tatedavenport/SwimmingSwarm/README.md

# Software Documentation
## Running the Code
- 2/25/2020 Release 0.0.1
- - Run Controller.py on the topside computer `python ./controller.py -mode joystick` (you can also pass 'keyboard' as the mode to use WASD + QE + CTRL + SHIFT for control)
- - Run Robot.py on the raspberry pi `python ./robot.py -host HOST_IP -port 8080` (passing the topside computer's ip in place of HOST_IP)

More usage information can be found [here](Documentation/Software/Usage.md).

## Setup
Follow the links from top to bottom for complete installation.

### [Topside Computer](Documentation/Software/TopsideComputer.md)
### [Raspberry Pi](Documentation/Software/RaspberryPi.md)
### [Pixhawk](Documentation/Software/Pixhawk.md)
-----

# Electrical Documentation
## [Electrical Design](Documentation/Electrical/ElectricalProduction.md)
## [ESC Setup](Documentation/Electrical/ESCs.md)
## [Electrical Hardware Information](Documentation/Electrical/ElectricalHardware.md)
-----

# [Mechanical Documentation](Documentation/Mechanical/Production.md)
-----

# Troubleshooting
See the Troubleshooting section [here](Documentation/Troubleshooting.md)
