tatedavenport/SwimmingSwarm/Documentation/Electrical/ElectricalHardware.md

# MicroSD Card 
Variety of brands. Just make sure you have at least a 16 GB card to insure you have enough memory for the .img.

# Raspberry Pi Zero W
[Raspberry Pi Link](https://www.adafruit.com/product/3400)

# Batteries: 
Size: 18650  
Nominal Capacity: 2500mAh  
Nominal Voltage: 3.7V   
Maximum Voltage: 4.2V
*[more information](https://secondlifestorage.com/t-LG-LGDBHE21865-Cell-Specifications--1938)*

## Charging Batteries
The batteries can now be charged via the BMS board (listed below). Plug a 5-24VDC power source into the barrel jack (> 2amp recommended). Batteries are fully charged when all 3 LEDs are lit. We've been using a 24V power supply.

# Battery Managment Board
[Dayton Audio LBB-3v2](https://www.parts-express.com/Dayton-Audio-LBB-3v2-3-x-18650-Lithium-Battery-Charger-Board-Module-12V-with-Charge-Protect-325-201) 3x 18650 Lithium Battery Board with Charge Protection

# Pixhawk - PX4
[PX4](https://docs.px4.io/en/flight_controller/pixhawk.html)

# Power Distribution board 
12V and 5V BEC w/ LC filtering supports up to 3A current.  
Size: 36 x 50 x 8mm
Net weight: 11g

[PDB Link](https://www.amazon.com/FPVDrone-Matek-PDB-XT60-Distribution-Quadcopter/dp/B06ZYFY89Z)

# Brushless DC Motors 
[Horizontal Thrusters](https://www.amazon.com/Crazepony-ECO2306-2400KV-Brushless-Racing/dp/B07T717JCC) - 2300KV Brushless Motors

[Vertical Thrusters](https://www.amazon.com/FPVDrone-7500KV-Brushless-Racing-Quadcopter/dp/B077GKLSP7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) (outdated)

# Electronic Speed Controllers
[ESC link](https://www.amazon.com/Makerfire-BLHeli-Brushless-Controller-QAV210/dp/B07867ZMFJ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) (outdated)
