tatedavenport/SwimmingSwarm/Documentation/Images/Masterpiece.png

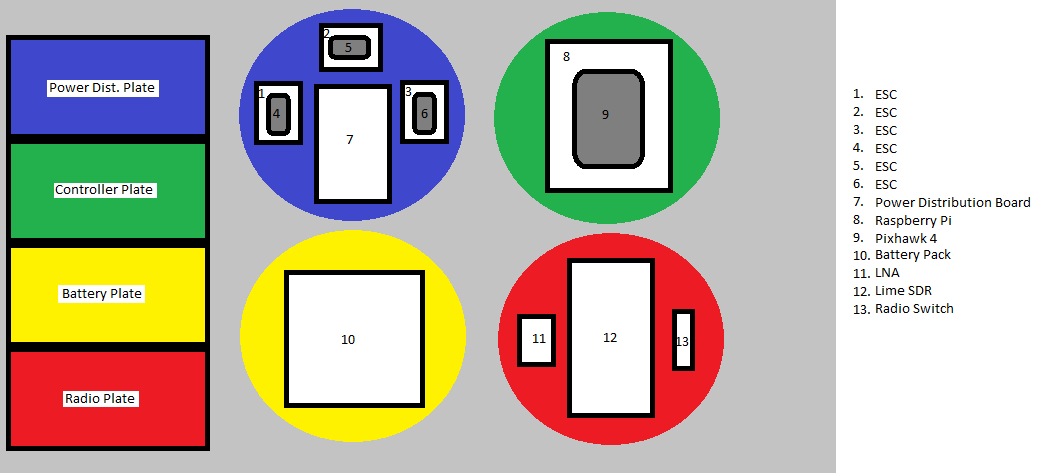
Documentation/Images/Masterpiece.png
