tatedavenport/SwimmingSwarm/Documentation/Swimming Swarm Parts List.xlsx

Sheet: Mick's Bots Components
Name | Manufacturer | Part # | Price | Quantity Needed | Purchase Link | Dimensions | Mass | Notes
Heat-Set Inserts, M4 x 0.7 mm, 4.7 mm | McMaster Carr | 94180A353 | $8.62 per 50 | 1 | https://www.mcmaster.com/#94180a353/=1d9pru1 |  |  | 5.7 - 5.99
Button Head Hex Screw, M2 x 0.40 mm, 8mm Long | McMaster Carr | 92095A454 | $6.38 per 25 | 1 | https://www.mcmaster.com/#92095a454/=1dgbvdc
Extended-Tip Set Screws, M4 x 0.7 mm, 8mm | McMaster Carr | 92775A118 | $7.29 per 25 | 1 | https://www.mcmaster.com/#92775a118/=1de9t0b
18-8 Stainless Steel Dowel Pin, M4 x 16 mm | McMaster Carr | 91585A454 | $7.91 per 26 | 1 | https://www.mcmaster.com/#91585a454/=1dgbhkh
Button Head Hex Drive Screw, M4 x 10 | McMaster Carr | 92095A190 | $9.05 per 100 | 1 | https://www.mcmaster.com/#92095a190/=1dec0au
O-Ring (162) | McMaster Carr | 9452K181 | $9.24 | 1 | https://www.mcmaster.com/#9452K181
Button Head Hex Drive Screw, M2 x.4mm | McMaster Carr | 92095A451 | $3.75 | 2 | https://www.mcmaster.com/#92095A451
18-8 Stainless Steel Hex Nut | McMaster Carr | 91828A111 | $4.50 | 1 | https://www.mcmaster.com/#91828A111
18-8 Stainless Steel Threaded Rod | McMaster Carr | 90024A219 | $4.86 | 1 | https://www.mcmaster.com/#90024A219
Sheet Lead (1/8'' thickness) | Amazon |  | $31 per 1sq ft | 1 | https://www.amazon.com/gp/product/B00IS5EEZ6/ref=s9_dcacsd_dcoop_bw_c_x_5_w
Brass Rods | Amazon |  | $13.11 | 1 | https://www.amazon.com/Unpolished-Finish-Temper-Diameter-Length/dp/B00GWYMPOC?s=industrial
18650 Battery Holder | Amazon |  | $5.66 |  | https://www.amazon.com/SMAKN%C2%AE-Plastic-Battery-Holder-Batteries/dp/B00NX8PW9A
MT30 Connector | HobbyKing |  | $3.27 per 4 | 2 | https://hobbyking.com/pt_pt/mt30-3-pole-motor-esc-connector-set-16awg-male-female-4-sets.html?___store=pt_pt
Red Wire | HobbyKing |  | $1.14 | 1 | https://hobbyking.com/en_us/turnigy-high-quality-20awg-silicone-wire-2m-red.html?___store=en_us
Black Wire | HobbyKing |  | $1.39 | 1 | https://hobbyking.com/en_us/turnigy-high-quality-20awg-silicone-wire-2m-black.html?___store=en_us
7500 KV Brushless Motor | GearBest |  | $7.59 | 4 | https://www.gearbest.com/motor/pp_634541.html?wid=1433363&currency=USD&vip=4264393

Sheet: Electronics
Name | Manufacturer | Part # | Price Per Component | Quantity Needed | Quantity Have | Dimensions | Mass | Notes | Purchase Link
Computers
Pixhawk |  |  | $179.90 | 1 | >1 | 81.5x50x15.5 mm | 38 g |  | https://store.mrobotics.io/Genuine-PixHawk-Flight-Controller-p/mro-pixhawk1-minkit-mr.htm
Raspberry Pi 3 Model B |  |  | $35.00 | 1 | >4 |  |  |  | https://www.adafruit.com/product/3055?src=raspberrypi
Motors
Large Brushless Motors |  | DST-700 | $8.27 | 4 | >4 |  |  | Maybe use a smaller motor | https://hobbyking.com/en_us/turnigy-aerodrive-dst-700-brushless-outrunner-motor-700kv.html?___store=en_us
Vertical Brushless Motors | HGLRC | HF 1104 7500kv | $10.79 | 4 | 0 | 14 diam x 12.5 mm | 6g |  | https://www.hglrc.com/products/hglrc-flame-1104-7500kv-micro-brushless-motor-for-xjb-75-mini-fpv-racer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
Electronic Speed Controller | Makerfire |  | $8.25 | 6 | >4 |  |  |  | https://www.amazon.com/Makerfire-BLHeli-Brushless-Controller-QAV210/dp/B07867ZMFJ?s=toys-and-games
Radio
Low Noise Broadband Amplifier |  | ZFL-500LN+ | $87.95 | 1 | >4 |  | 38 g | This comes in an SMA version too | https://www.minicircuits.com/WebStore/dashboard.html?model=ZFL-500LN%2B
SPDT RF Switch |  | ZX80-DR230-S+ | $59.95 | 1 | >3 |  | 56 g |  | https://www.minicircuits.com/WebStore/dashboard.html?model=ZX80-DR230-S%2B
Lime SDR |  |  | $299.00 | 1 | 3 |  |  | Might be able to use mini? | https://www.crowdsupply.com/lime-micro/limesdr
Batteries
18650 Li-ion Cell | Kastar | LGDBHE21865 | $6.00 | 4 | >20 |  | 45g |  | https://www.amazon.com/Kastar-LGDBHE21865-Lithium-ion-Rechargeable-Flashlights/dp/B01EKNBB32
18650 Battery Holder |  | BK-18650-PC8 | $6.30 | 1 | 0 |  | 30g |  | https://www.digikey.com/product-detail/en/mpd-memory-protection-devices/BK-18650-PC8/BK-18650-PC8-ND/2330515
4S BMS Board |  | HH-P3-10.8 | $2.50 | 1 | >6 |  |  |  | https://www.ebay.com/p/4a-5a-PCB-BMS-Protection-Board-for-4-Packs-18650-Li-ion-Lithium-Battery-Cell/575026470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
6 ESC Power Distribution Board |  |  | $12.99 | 1 | 0 |  | 34g | see note to the right of the url | https://www.google.com/shopping/product/603150142762209793?rlz=1C1GCEA_enUS798US798&biw=1680&bih=944
Induction System
Inductance Charger |  |  | $13.95 | 1-2 | 0 |  |  |  | https://www.amazon.com/1-5A-Wireless-Charger-Power-Supply/dp/B00XKS7FES
N Channel Power MOSFET | Infineon | IRFZ44NPBF | $0.91 | 0-2 | 0 |  |  | May need a heatsink / Be bigger | https://www.mouser.com/ProductDetail/Infineon/IRFZ44NPBF?qs=9%252bKlkBgLFf24zghzPg2f9g%3D%3D
P Channel Power MOSFET | Infineon | IRF4905PBF | $1.74 | 0-2 | 0 |  |  | May need a heatsink | https://www.mouser.com/ProductDetail/Infineon-Technologies/IRF4905PBF
500 mF Capacitor | Illinois Capacitor | DGH504Q5R5 | $2.11 | 0-1 | 0 |  |  | May not need + could be smaller? | https://www.digikey.com/product-detail/en/illinois-capacitor/DGH504Q5R5/1572-1776-ND/7387523
No longer needed
Power Distribution Board | Matek |  | $9.99 | 1 | >4 | 36x36x4 mm |  |  | https://www.getfpv.com/matek-mini-power-hub-with-bec-5v-12v.html
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
