tatedavenport/SwimmingSwarm/(commit log)

2018-07-18 Don't print when recieving empty data
2018-07-23 Added motors and ESC
2018-07-23 Add links for motors and esc's
2018-07-24 Update pwm values
2018-07-24 Switch controller to vizier
2018-07-25 Add information about building Ardusub
    Also added instruction on setting the frame config parameter
2018-07-25 Add raspberry pi sudo password
2018-07-25 lower case mosquitto because that matters
2018-07-26 Move BLHeli to ESC page
2018-07-26 Move ESC Image
2018-07-26 Add ESC Setup
2018-07-26 Fix ESC Link
2018-07-26 Add more detailed battery charging instructions
2018-07-27 Add Parts List
    [Swimming Swarm Parts List.xlsx]
2018-07-27 Add Raspberry Pi Pinout
2018-11-04 fixed node_desc jsons and removed random import
    [robot.py]
2019-02-03 Added custom Ardusub frame
2019-02-10 First commit keyboard controls (not working)
    [pyGui.py]
2019-10-08 Drone wait on broker and stabilise gimbal, speed
    [controller.py, robot.py]
2019-12-01 channel_command convert to pwm value
2019-12-01 Fix local mode and channel override
    [robot.py]
2019-12-01 Fix host IP and print for convenience
2019-12-01 Move pwm generation to controller
2019-12-01 Fix manual stabililised control
    [controller.py, robot.py]
2019-12-02 Change PWM max and min
2019-12-02 Remove stablize_control that doesn't do anything
    [robot.py]
2019-12-02 max, min pwm change
2019-12-02 Fix missing arg in robot_test
    [controller.py]
2020-03-06 reduced max power
2020-10-01 Issues with the get_selected_bot function in pyGui.py, which still needs to be implemented
    [pyGui.py]
2020-11-15 Added real distance trackingto pixyController. Also switched the coordinate system from being centered in the top left to the actual center
2020-11-17 Added in unit argument to print statements
2020-11-17 added electrical stack cad
2020-11-18 Tracking with csv stuff
    [output.csv]
2021-01-13 Switch all documentation links to relative links
2021-01-13 Fix relative link issues and switch images link
2021-02-15 Update firmware to correct version
    [controller.py]
2021-03-23 Fix robot sitl modularization
    [robot.py]
2021-03-23 Clamp motor force to max_motor_force
2021-03-24 Fix turning the long way
    [robot_simulation.py, simulation.py]
2022-01-16 moving from gatech github
    [output.csv]
